vaxdatex/DIYVCO3/OSCPNL2_Montaza/OSCPNL2-layout.pdf

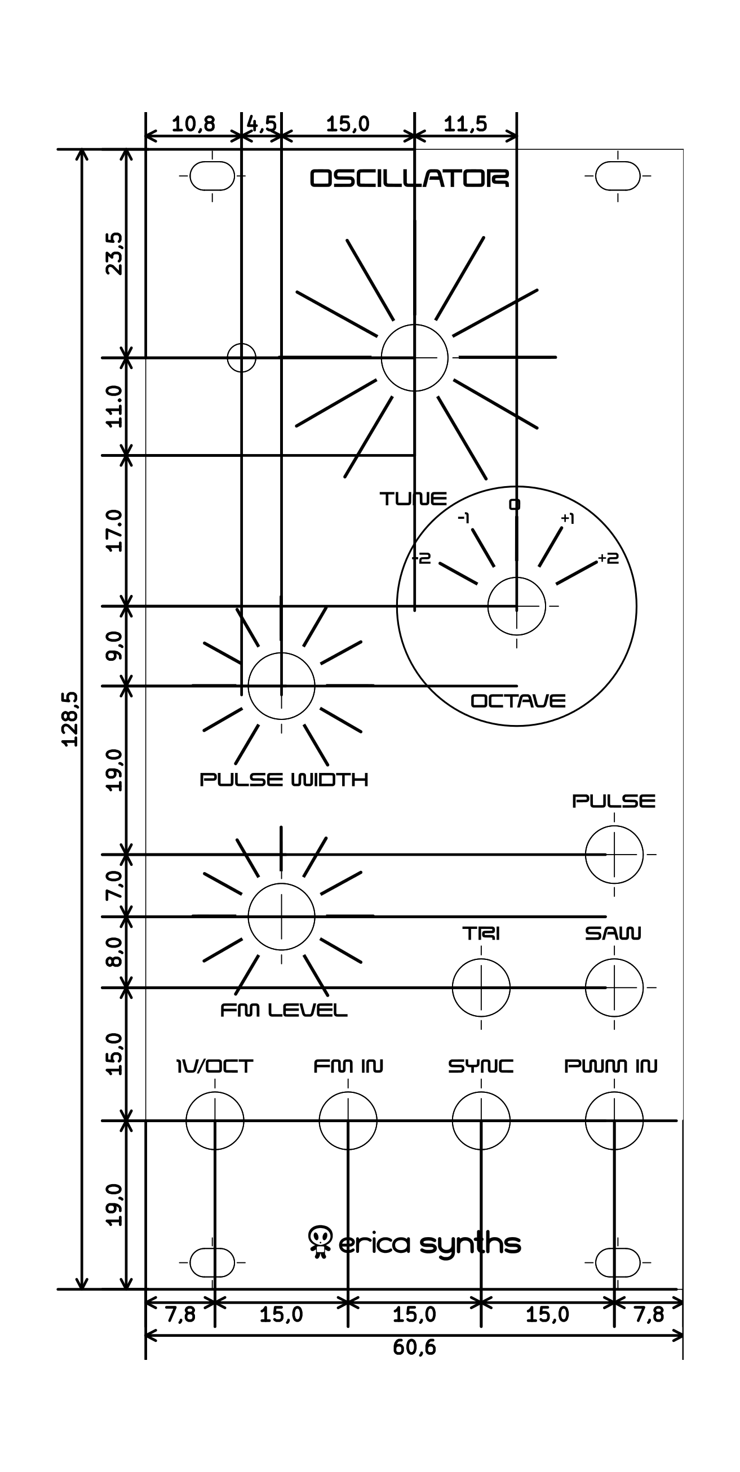
[picture p1: page 1]
