vaxdatex/DIYVCO3/OSCPNL2_Montaza/OSCPNL2-layout_noDim.pdf

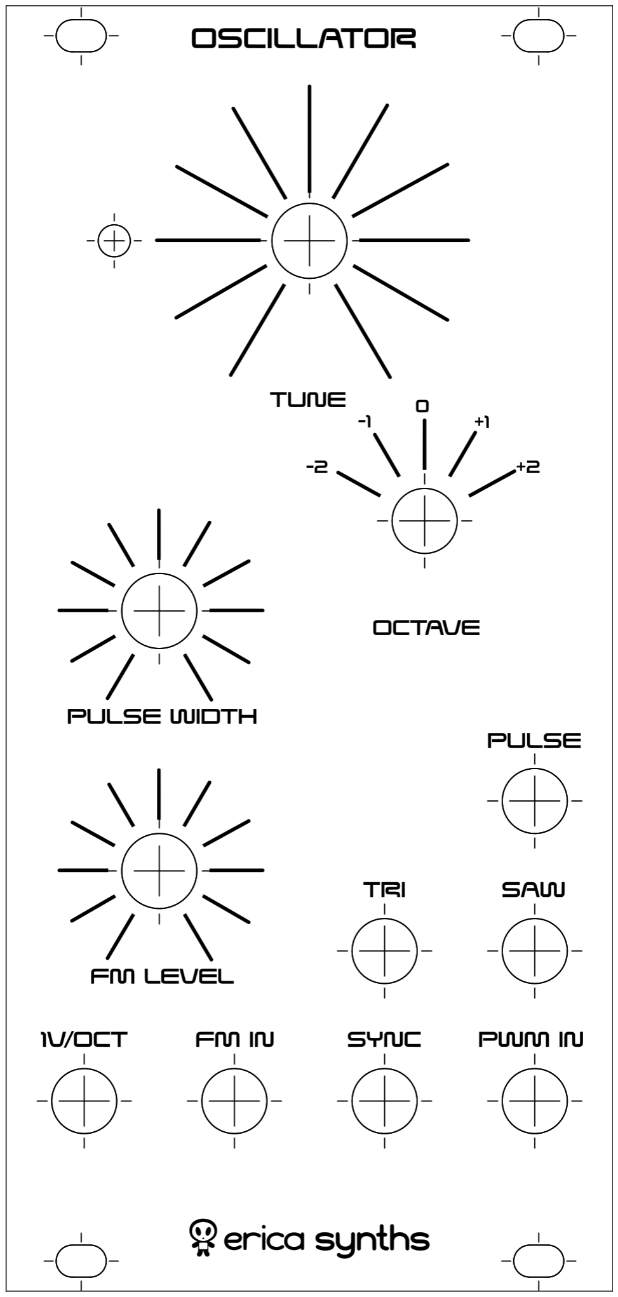
[picture p2: page 1]
