vaxdatex/DIYVCO3/Controls/DIYVCO3C_BOM.xls

 | Erica Synths DIY Polivoks VCO v3.0 June 2020
Id | Designator | Package | Quantity | Designation | Supplier and ref
1 | DA6 | TO-92 | 1 | LM337L
2 | DA7 | TO-92 | 1 | LM317L
3 | R98,R9,R10,R48,R96,R97 | R_W4_THT | 6 | 100k
4 | VD1,VD2 | DO-41 | 2 | 1N4001
5 | VR1,VR2 | RB090-30 | 2 | ERF-RB-090-30
6 | R33 | R_TRIM_T93YAx | 1 | 1k
7 | C22,C5,C6,C25,C31,C34 | C-5mm | 6 | 0.1uF
8 | C1 | C-5mm | 1 | 47pF
9 | C3,C4 | CE63x25 | 2 | 47uFx25V
10 | L1,L2 | R0125W | 2 | 100uH
11 | R6 | R_W4_THT | 1 | 150k, 1%
12 | R8 | RD901F | 1 | 100k | Thonk, Tayda
13 | R11,R16,R49,R71,R89 | R_W4_THT | 5 | 10k
14 | R13,R15 | R_W4_THT | 2 | 27k, 1%
15 | R14,R62 | RD901F | 2 | 10k | Thonk, Tayda
16 | R78,R79,R80 | R_W4_THT | 3 | 470
17 | VD3,VD4,VD5,VD6,VD9,VD10,VD16,VD17,VD18,VD19,VD20,VD21 | DO-35 | 12 | 1N4148
18 | XP1 | IDC-10MS | 1 | IDC-10MS
19 | XS1,XS2,XS3,XS4,XS5,XS6,XS7 | WQP-PJ301M-12 | 7 | WQP-PJ301M-12 | Thonk
20 | XS8,XS9,XS10,XS11 | PBS-8 | 4 | PBS-8_FEMALE
21 | C30 | C-5mm | 1 | 10nF
22 | C33,C36 | CE63x25 | 2 | 10uFx25V
23 | R86,R90 | R_W4_THT | 2 | 22k
24 | R88,R91 | R_W4_THT | 2 | 1k
 | PCB:DIYVCO3C
