vaxdatex/DIYVCO3/Main/DIYVCO3M_BOM.xls

 | Erica Synths DIY Polivoks VCO v3.0 June 2020
Id | Designator | Package | Quantity | Designation | Supplier and ref
1 | R7 | R_TRIM_T93YAx | 1 | 10k
2 | C21 | C-5mm | 1 | 47pF
3 | VT1,VT3,VT4,VT6 | TO-92-M | 4 | 2N3904
4 | VT2,VT5 | TO-92-M | 2 | 2N3906
5 | R31,R94 | R_W4_THT | 2 | 33k, 1%
6 | R32 | R_W4_THT | 1 | 10k, 1%
7 | R92 | R_W4_THT | 1 | 120k, 1%
8 | R93 | R_W4_THT | 1 | 470k, 1%
9 | R1,R2,R3,R4,R5,R18,R34,R40,R54,R55,R83 | R_W4_THT | 11 | 10k
10 | R12,R25,R57 | R_W4_THT | 3 | 56k
11 | R17,R24,R52 | R_W4_THT | 3 | NU
12 | R19,R68 | R_W4_THT | 2 | 20k
13 | R20,R22,R41,R46,R60,R63,R65,R70,R76,R82,R85,R61 | R_W4_THT | 12 | 100k
14 | R23 | R_W4_THT | 1 | 270
15 | R26 | R_W4_THT | 1 | 360k
16 | R27,R28,R29,R30 | R_W4_THT | 4 | 100k, 1%
17 | R35,R39,R44 | R_W4_THT | 3 | 100, 1%
18 | R36 | R_W4_THT | 1 | 1k, 1%
19 | R37 | R_W4_THT | 1 | 910, 1%
20 | R38 | R_W4_THT | 1 | 8.2k
21 | R42 | R_W4_THT | 1 | 6.19k, 1%
22 | R43 | R_W4_THT | 1 | 470
23 | R47,R51 | R_W4_THT | 2 | 6.8k
24 | R53 | R_W4_THT | 1 | 75k
25 | R56,R73 | R_W4_THT | 2 | 22k
26 | R58 | R_W4_THT | 1 | 15k
27 | R59 | R_W4_THT | 1 | 47k
28 | R64,R67 | R_W4_THT | 2 | 33k
29 | R66 | R_W4_THT | 1 | 30k
30 | R69 | R_W4_THT | 1 | 5.6k
31 | R72,R81,R84 | R_W4_THT | 3 | 4.7k
32 | R74,R75 | R_W4_THT | 2 | 6.19k
33 | R77 | R_W4_THT | 1 | 18k
34 | R95 | R_W4_THT | 1 | 200k
35 | R87 | R_W4_THT | 1 | 10M
36 | SW1 | DS1PC1x12 | 1 | CK1049 | 6 or 12 position rotary switch, fix to 5 positions!
37 | C2,C26,C27,C28 | CE63x25_NP | 4 | 10uFx25V | non-polarized!!!
38 | C7,C8,C9,C10,C11,C12,C13,C14 | C-5mm | 8 | 0.1uF
39 | C15 | C-5mm | 1 | 2.7nF
40 | C16 | C-5mm | 1 | 47nF
41 | C17 | C-5mm | 1 | 100pF
42 | C18 | C-5mm | 1 | 2.2nF
43 | C19 | C-5mm | 1 | 330pF
44 | C20 | CE63x25 | 1 | 22uFx25V
45 | C23 | C-5mm | 1 | 5600 FILM
46 | C24 | C-5mm | 1 | NU
47 | C29 | CE63x25 | 1 | 47uFx25V
48 | DA1,DA2,DA3 | DIP-14_Socket | 3 | TL074
49 | VD7,VD8,VD13,VD14,VD15,VD11 | DO-35 | 6 | 1N4148
50 | DA5 | DIP-14_Socket | 1 | KR198NT1A | ebay or www.ericasytnhs.lv (http://www.ericasynths.lv/)
51 | XP2,XP3,XP4,XP5 | PLS-8 | 4 | PLS-8_MALE
52 | C35,C32 | C-5mm | 2 | 10nF
53 | DA4 | DIP-8_Socket | 1 | TL072
54 | R21 | CA6V | 1 | 100k
55 | R50,R45 | CA6V | 2 | 1k
 | PCB:DIYVCO3M
