vaxdatex/DIYVCO3/DIYVCO3.pdf

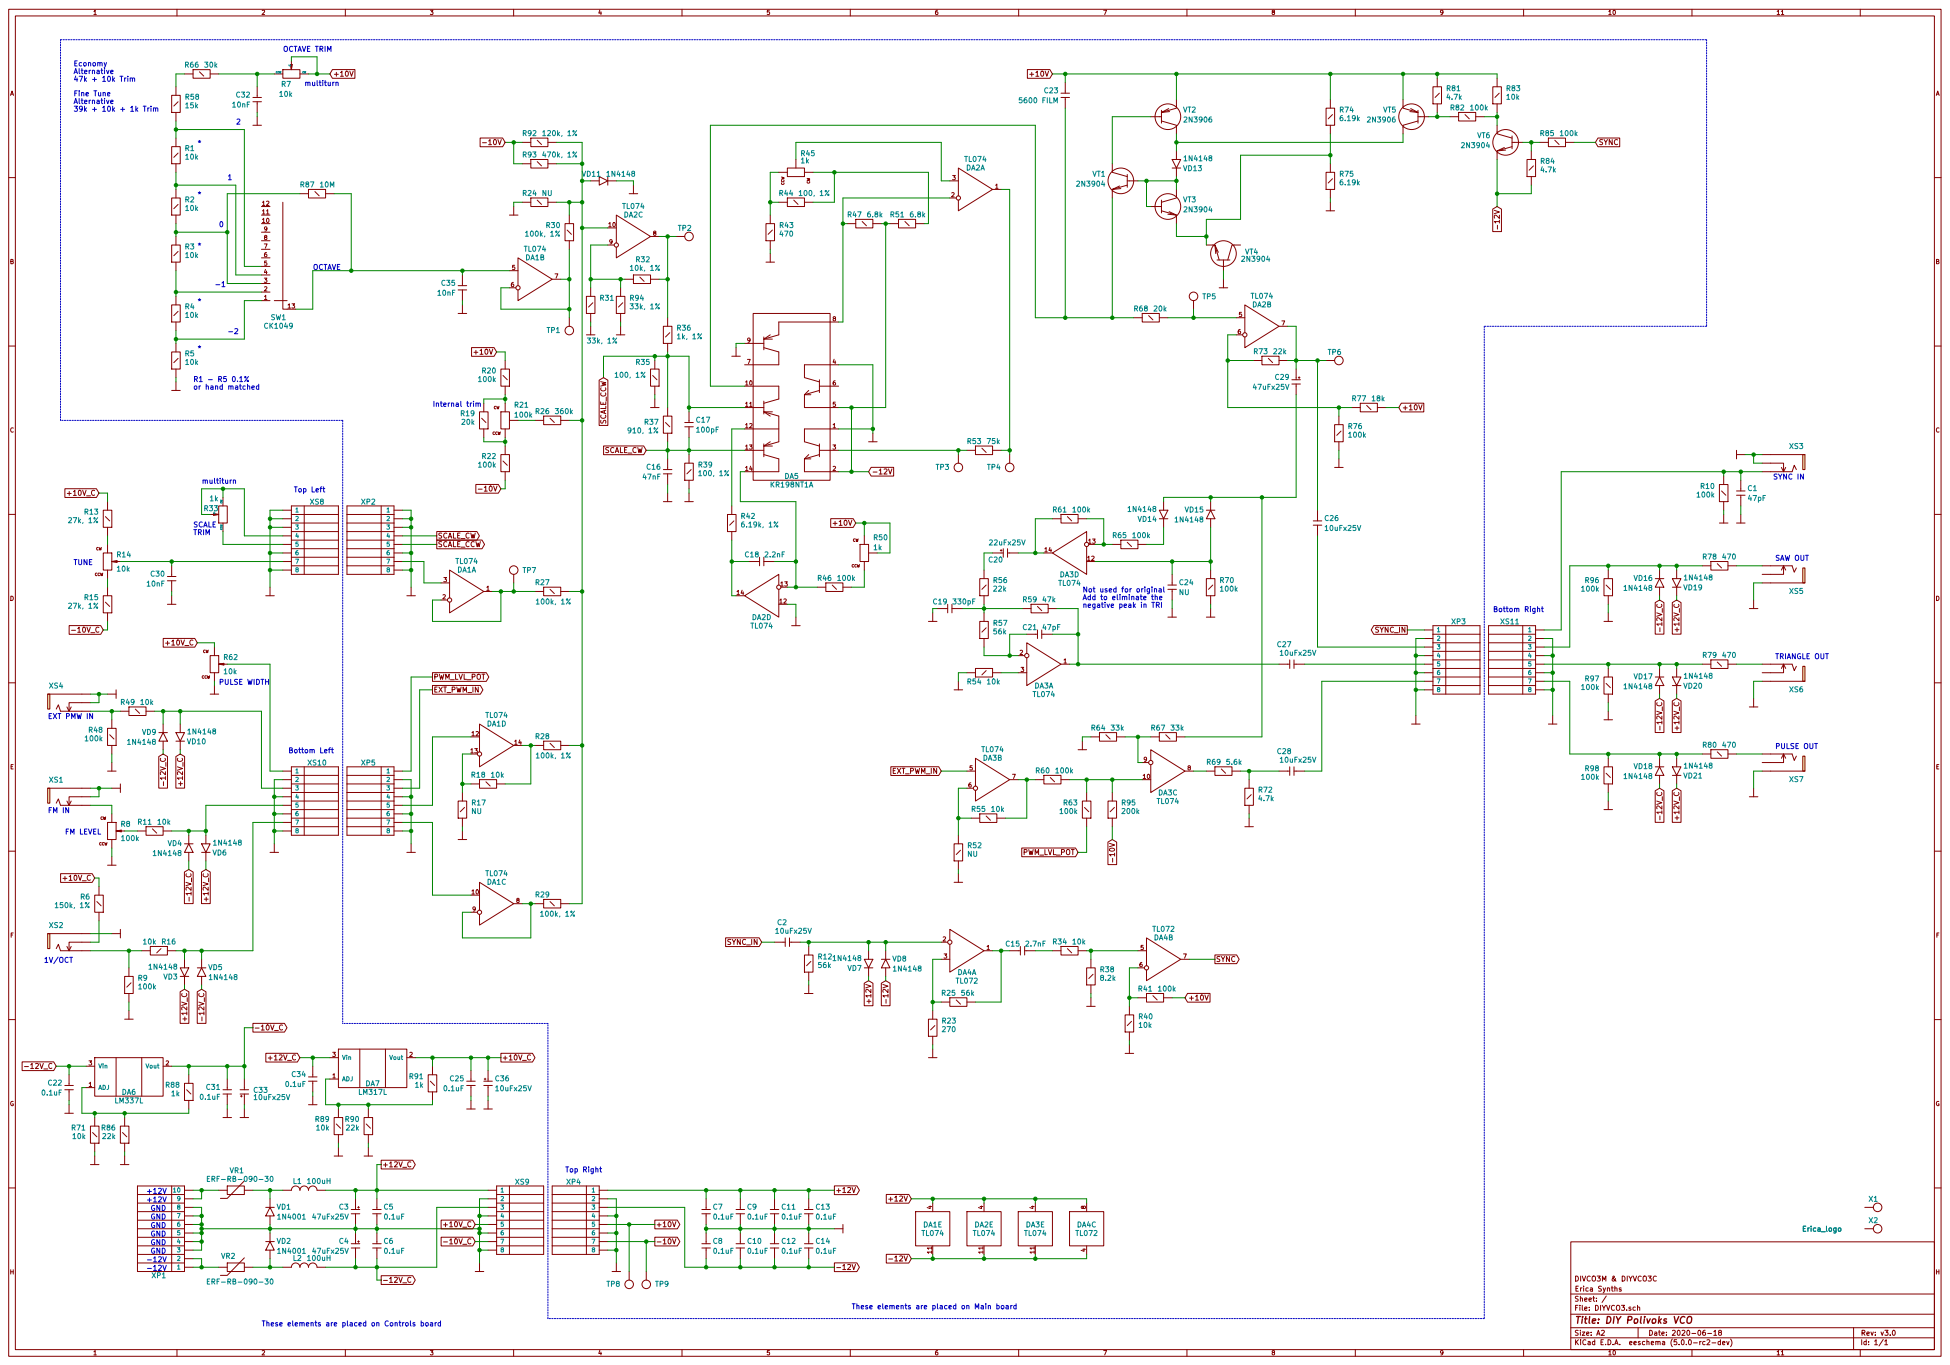
[picture p3: page 1]

2N3904 Not used for original Add to eliminate the negative peak in TRI 1

XS3 FM LEVEL FM IN

8 3 | XP3 | 8 XS11 3

GND | 3
-12V | 2
-12V | 1

File: DIYVCO3.sch Sheet: / Erica Synths DIVCO3M & DIYVCO3C

These elements are placed on Main board

These elements are placed on Controls board

Id: 1/1 Title: DIY Polivoks VCO
